sfiro/cubo-led-9x9x9/CircuitoCuboLED.jpg

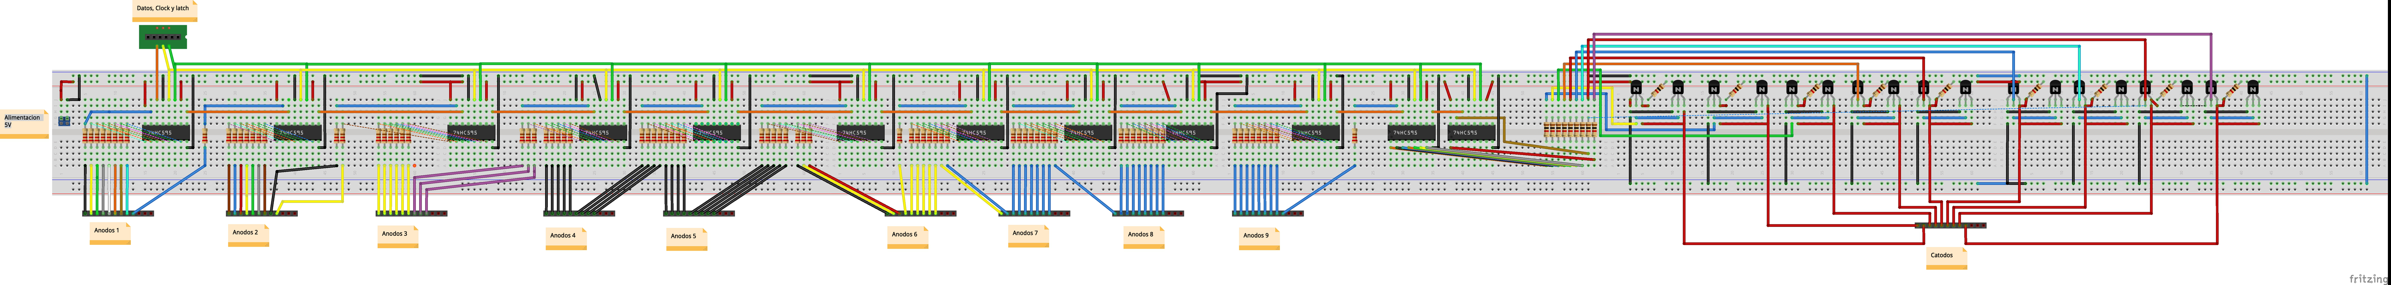
CircuitoCuboLED.jpg
