sfiro/cubo-led-9x9x9/CircuitoCuboLED_esquemático.jpg

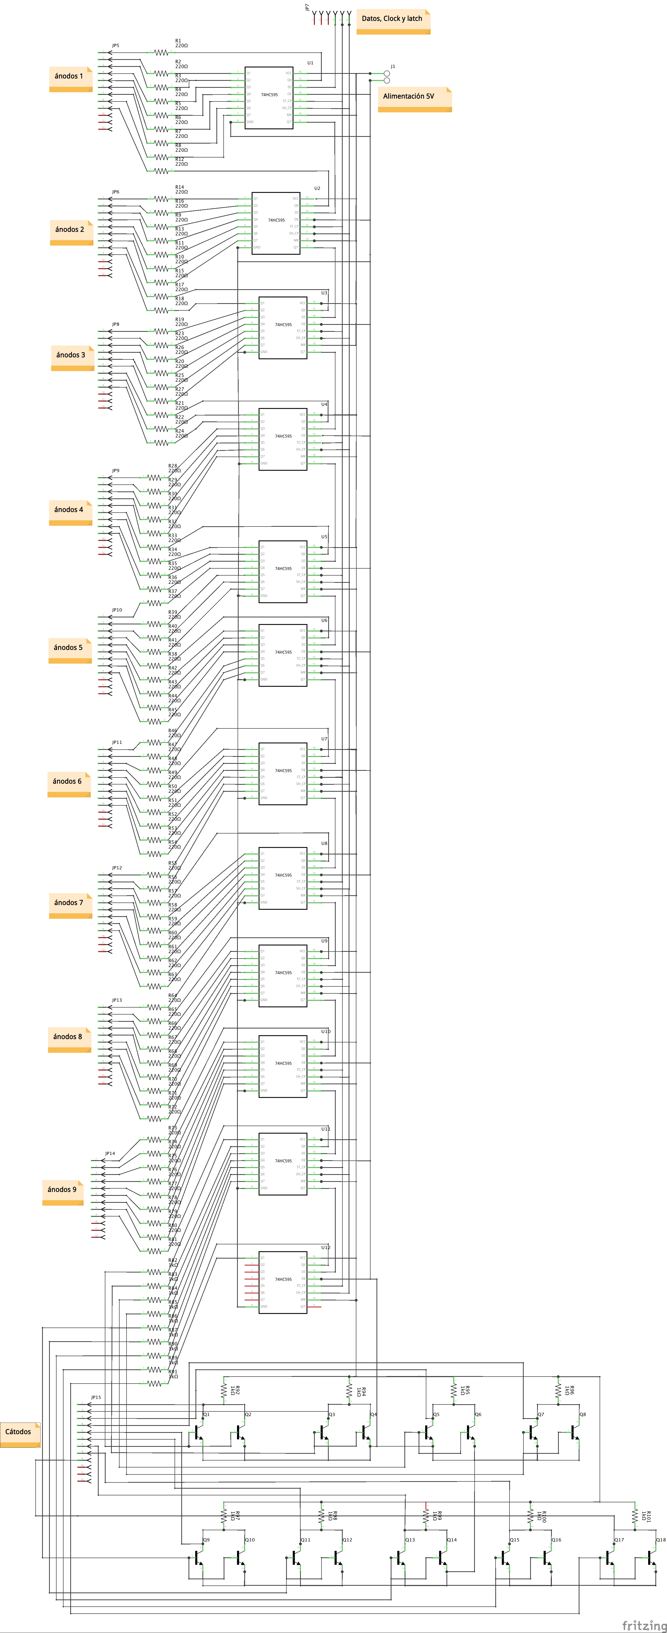
CircuitoCuboLED_esquemático.jpg
