sfiro/cubo-led-9x9x9/cubo Esquematico.jpg

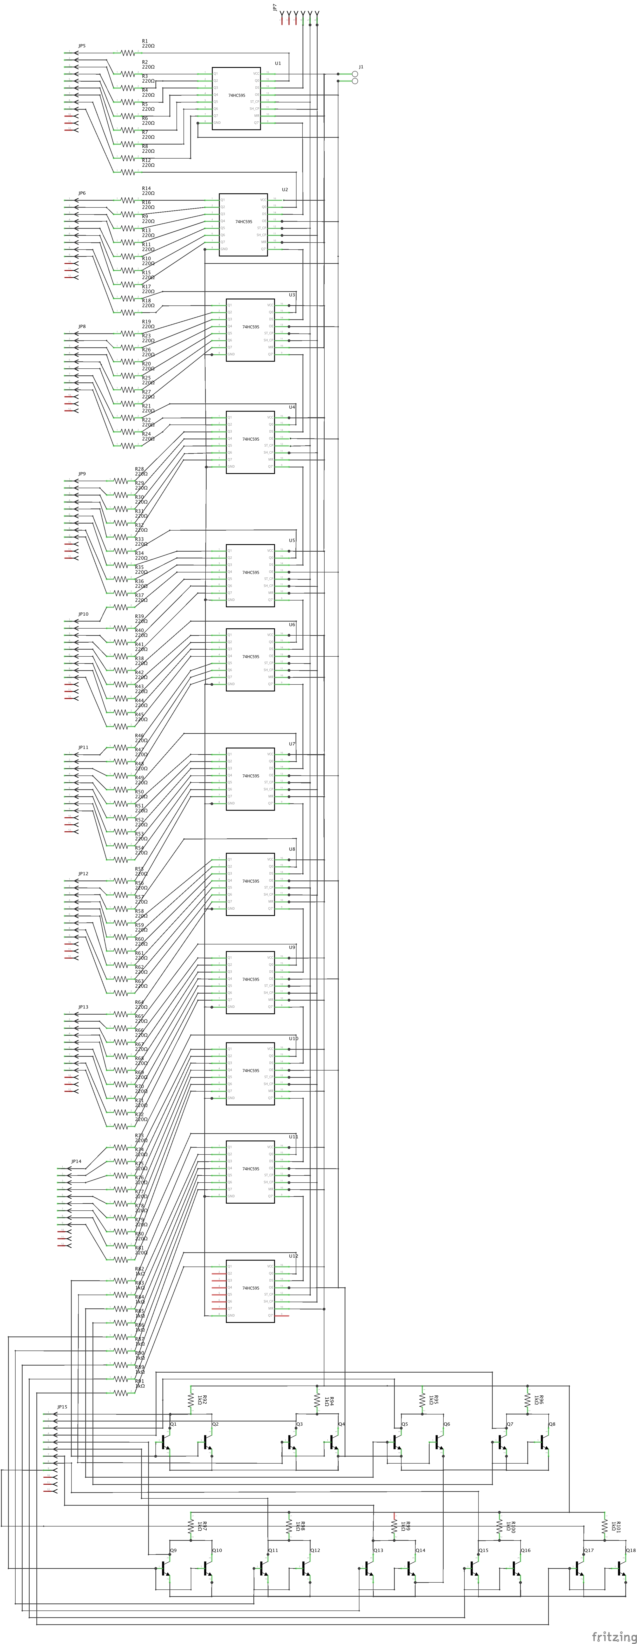
cubo Esquematico.jpg
