sfiro/cubo-led-9x9x9/(list of files, drawings)

Other design files:
CircuitoCuboLED.fzz
