sfiro/cubo-led-9x9x9/(commit log)

2026-10-27 Cubo LED 9x9x9: sketches de Arduino (2019) y port a Raspberry Pi Pico W
    - Sketches originales de Arduino y esquemáticos de Fritzing.
    - pico_w/: driver MicroPython con PIO+DMA y doble búfer, 14 animaciones
    portadas (con bugs del original corregidos), control por WiFi y prueba
    de cableado.
    - README.md y model.md con la descripción del proyecto y del sistema.
    [CircuitoCuboLED.fzz]
2026-10-27 Simulador 3D del cubo en el navegador, listo para GitHub Pages
    - simulador/: visor Three.js que ejecuta pico_w/animaciones.py sin cambios
    con MicroPython WebAssembly en un Web Worker.
    - Reloj virtual para pausa, avance cuadro a cuadro y velocidad.
    - Editor de animaciones con consola de errores y deteccion de cuelgues.
    - index.html raiz que redirige al simulador y .nojekyll para Pages.
    - README.md, model.md y simulador/LEEME.md actualizados.
2026-10-27 Animaciones: lluvia, disparos y planos mejoradas, y 9 nuevas
    - lluvia: continua, con velocidades distintas, viento, estela y salpicaduras.
    - disparos: varios proyectiles desde las 6 caras con onda expansiva al chocar
    (reemplaza a disparos_triples).
    - planos: planos que se abren desde el centro, plano diagonal y plano giratorio.
    - Nuevas: marquesina, cubo_giratorio, helice, tornado, rebotes, fuente, olas,
    vida (3D, regla B5/S4567) y espectro.
2026-10-27 Animaciones: 12 efectos clasicos de otros cubos LED
    - Del effect.c de chr (8x8x8): cajas, envios, carita, espiral, cinta y
    esfera_movil.
    - Del cubo L3D: matrix, rayo, nieve, pacman, arbol y reloj.
    - reloj: la Pico sincroniza la hora por NTP al conectarse y usa
    ZONA_HORARIA de config.py; el simulador usa la hora real.
